timex-sinclair-projects/Pico-Speech-Synth-2068/docs/Speech Synth Notes.md

# Notes

## SC-01 info

- https://forums.raspberrypi.com/viewtopic.php?t=69915
- https://www.redcedar.com/sc01.htm
