timex-sinclair-projects/Pico-Speech-Synth-2068/docs/ZX Voice Schematic (Rigter 1986).jpeg

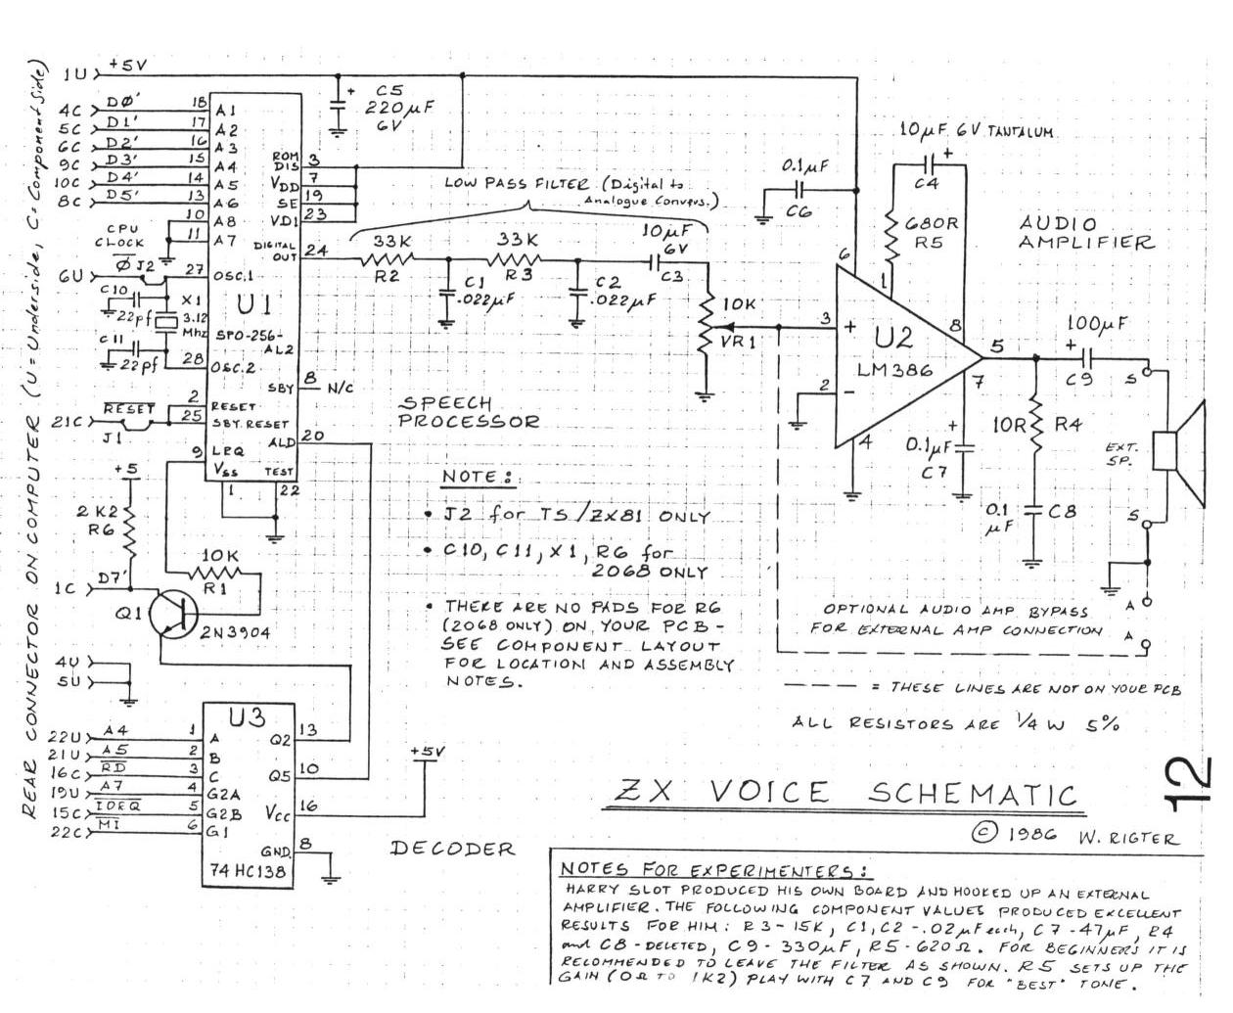
docs/ZX Voice Schematic (Rigter 1986).jpeg
