timex-sinclair-projects/Pico-Speech-Synth-2068/images/Speech Synth 2068 pcb.png

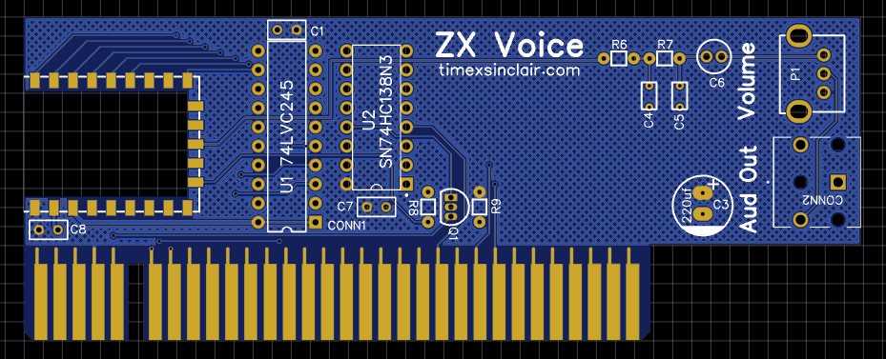
images/Speech Synth 2068 pcb.png
