timex-sinclair-projects/Pico-Speech-Synth-2068/pcb/BOM_Speech Synth 2068 Pico_2023-12-23.csv

ID | Name | Designator | Footprint | Quantity
1 | 100nF | C1,C7,C8 | 100NF | 3
2 | 220uf | C3 | CAP-D8.0XF3.5 | 1
3 | 22nf | C4,C5 | 0.022UF | 2
4 | 10uf | C6 | CAPACITOR_10UF | 1
5 | TS2068 Expansion Card | CONN1 | TS2068 EXP CARD EDGE | 1
6 | STX-3120-3B | CONN2 | KYCON_STX-3120-3B | 1
7 | 10k | P1 | PTV09A-2020F-A103 | 1
8 | 2N3904 | Q1 | TO-92-3_L5.1-W4.1-P1.27-L | 1
9 | 10k | R6,R7,R8 | 1/8W RESISTOR | 3
10 | 2.2k | R9 | 1/8W RESISTOR | 1
11 | 74LVC245 | U1 | 74LVC245 | 1
12 | SN74HC138N3 | U2 | PDIP-16_L19.3-W6.4-P2.54-LS7.9-BL | 1
13 | RP2040 ZERO SMD | U4 | RP2040 ZERO SMD | 1
