timex-sinclair-projects/Pico-Speech-Synth-2068/pcb/Schematic_Speech Synth 2068 Pico_2023-12-23.pdf

# GP14 15 GP15 16 GP26 17 GP27 18 GP28 19 GP29 20 3V3 21 GND 22 5V 23

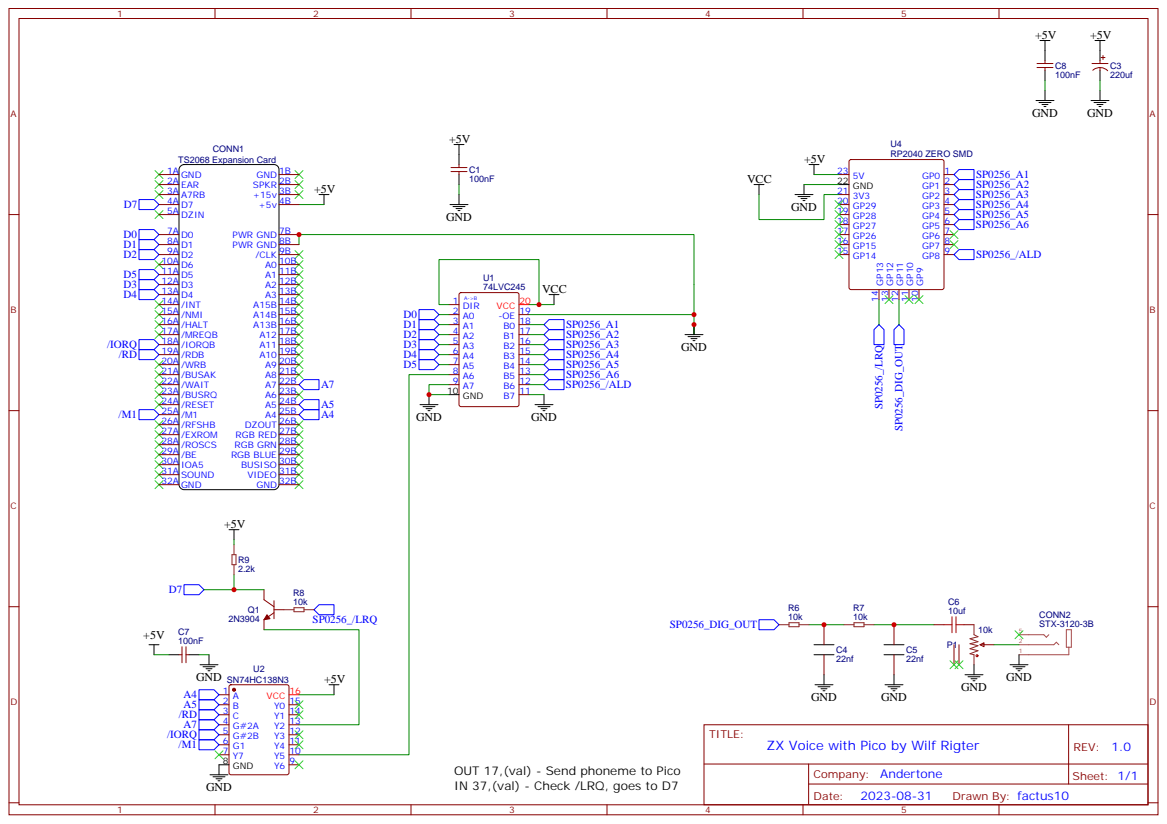
[picture p3: page 1]

OUT 17,(val) - Send phoneme to Pico
IN 37,(val) - Check /LRQ, goes to D7
