timex-sinclair-projects/Pico-Speech-Synth-2068/firmware/boards/zxvoice_revb.h

/*
 * zxvoice_revb.h -- Pico SDK board header for the ZX Voice Rev B card.
 * RP2040 with a W25Q32JVSSIQ (4 MB) on QSPI, 12 MHz crystal, no on-board
 * LED on GP25 (the SBY LED is on GP14 and driven by the firmware).
 */
#ifndef _BOARDS_ZXVOICE_REVB_H
#define _BOARDS_ZXVOICE_REVB_H

#define ZXVOICE_REVB

#ifndef PICO_XOSC_STARTUP_DELAY_MULTIPLIER
#define PICO_XOSC_STARTUP_DELAY_MULTIPLIER 64
#endif

#ifndef PICO_DEFAULT_UART
#define PICO_DEFAULT_UART 0
#endif
#ifndef PICO_DEFAULT_UART_TX_PIN
#define PICO_DEFAULT_UART_TX_PIN 0
#endif
#ifndef PICO_DEFAULT_UART_RX_PIN
#define PICO_DEFAULT_UART_RX_PIN 1
#endif

#ifndef PICO_FLASH_SPI_CLKDIV
#define PICO_FLASH_SPI_CLKDIV 2
#endif
#ifndef PICO_FLASH_SIZE_BYTES
#define PICO_FLASH_SIZE_BYTES (4 * 1024 * 1024)
#endif
#ifndef PICO_BOOT_STAGE2_CHOOSE_W25Q080
#define PICO_BOOT_STAGE2_CHOOSE_W25Q080 1
#endif

#ifndef PICO_RP2040_B0_SUPPORTED
#define PICO_RP2040_B0_SUPPORTED 1
#endif

#endif
