timex-sinclair-projects/Pico-Speech-Synth-2068/(commit log)

2023-12-23 Initial commit
    Initial PCB, BOM and gerbers
    [BOM_Speech Synth 2068 Pico_2023-12-23.csv]
2023-12-24 Image of pcb
2026-09-10 Rebuild as ROM emulation with C firmware and text-to-speech
    Replace the sample-playback approach with a portable C port of MAME's
    SP0256 core (BSD-3-Clause) driven by the SP0256-AL2 ROM image, and add
    everything around it:
    - core/: the emulation core, no allocation or floating point, with
    speed, pitch and clock controls
    - rom/: the ROM image (Microchip permission notice included)
    - harness/: desktop tools that render allophones and text to WAV and
    compare each entry's run time to the datasheet's Table 6
    - tts/: text-to-allophone engines, NRL rules (Wasser, public domain)
    with a datasheet Table 5 mapper, and the CTS256A-AL2 rule set
    (GmEsoft extraction, GPL-3.0), plus a small lexicon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
    [audio.c, audio.h, bus.c, bus.h, config.h, console.c]
2026-09-10 Add Rev B hardware design and pin-level netlist
    hardware/revb/: Protel-format netlist for EasyEDA Pro import, flat
    connection CSV and BOM, all generated by tools/revb_netlist.py, which
    checks that every pin is on exactly one net or declared no-connect.
    83 parts, 106 nets, 374 connections.
    docs/rev-b-hardware.html: the design page (block diagram, strict decode
    with 74HCT688 + 74HCT138, hardware-answered reads, level shifting through
    three 74LVC245s and a 74LVC1G125, RP2040 minimal circuit, MAX98357A I2S
    amplifier, diode-ORed bus/USB power, GPIO map, jumpers, BOM).
    Pinouts taken from datasheets; the MAX98357A needs LRCLK at 32 kHz, so
    the I2S back end must interpolate the 10 kHz stream.
    Co-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
    [zxvoice-revb-bom.csv, zxvoice-revb-nets.csv]
2026-09-10 Firmware 0.3: Rev B board define, I2S back end, clock sense, status byte
    One source tree builds for two boards, selected with -DZXV_BOARD:
    BOARD_ZERO2023 (the 2023 RP2040-Zero card, unchanged behaviour) and
    BOARD_REVB (hardware/revb). build.sh produces both UF2s.
    Rev B adds: READY-polarity D7 driver, MAX98357A I2S output at 32 kHz
    with Q16 linear interpolation of the 10 kHz stream (the amplifier does
    not accept a 10 kHz frame clock), amplifier enable with a 400 ms hold,
    status byte on GP20-27 for IN 55, bus clock measurement by PIO at boot
    (TS1000 gets the CPU-clock pitch as on the original, 2068 the crystal),
    /RDSTAT counting, board-ID jumpers with a mismatch warning, and a board
    header fo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
